watt-city/autonomous-car/(commit log)

2026-06-27 added sensor sheets
    [imu.kicad_sch, laserSensor.kicad_sch, ldo.kicad_sch, microcontroller.kicad_sch, power.kicad_sch, usb.kicad_sch, watt_city_car_pcb.kicad_sch]
2026-07-22 Initial commit
    Initial commit of the WATT City main board firmware for ESP32-S3, including setup for motors, sensors, and communication protocols.
2026-08-15 refactored repo so all car-related files are here added imu test code
    [imu.kicad_sch, laserSensor.kicad_sch, ldo.kicad_sch, microcontroller.kicad_sch, power.kicad_sch, usb.kicad_sch, watt_city_car_pcb.kicad_pcb, watt_city_car_pcb.kicad_sch]
2026-08-15 updated pcb
    [distSensor.kicad_sch, imu.kicad_sch, irArray.kicad_sch, laserSensor.kicad_sch, laserSensor0.kicad_sch, laserSensor1.kicad_sch, laserSensor2.kicad_sch, microcontroller.kicad_sch]
2026-08-15 renamed imu code, added calibrated laser dist sensor code
2026-08-15 qtr ir array working, calibrated to normalize readings from 0-1000
2026-08-15 added calibration code and hard-coded calibration constants into qtr_sensor_test
2026-08-18 integrated all sensors + ble
2026-08-18 initial pid line following code
2026-08-25 both motors working, encoders reading
2026-09-22 Tests motor controller & qtr sensor before PID
2026-09-22 Swap encoder pin definitions for ENC_R_A and ENC_R_B
2026-09-28 Enhance 'go' command with calibrated readings, base speed 2000 with lkp 0.5
2026-10-13 Remove KiCad backups and lock files, add .gitignore
    - Delete 70+ KiCad autosave zips, lock files, per-user .kicad_prl and
    an empty .history submodule entry from hardware/
    - Move the motor + encoder test from firmware/src/main/ into
    sensor_tests/motor_encoder_test/ so firmware/ only holds car sketches
    - Add .gitignore so these don't come back
    Claude-Session: https://claude.ai/code/session_01Wnp1WRYzGuosmDiJwmEC77
2026-10-13 Add README, CONTRIBUTING guide, and PR template
    README covers what the repo is, layout, setup, pin map, and known
    issues. CONTRIBUTING describes the branch + pull request workflow,
    KiCad and secrets rules. The PR template asks how changes were tested
    and what AI was used for.
    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
2026-11-04 main_board: read the camera's text TAG lines instead of the binary packet
    The team chose the text format that camera/firmware/xiao_apriltag_largest
    already sends. watt_link.h drops VisionPacket and the UART framing, keeps
    V2XPacket, and adds watt_parse_tag_line().
    - pollVision() assembles newline-terminated lines and parses them
    - Red-light stop uses the tag's apparent size (TAG_STOP_SIDE_PX, an
    estimate to replace with a measured value) since text has no range
    - Drops the camera "obstacle" flag; the ToF stop is unchanged
    Parser unit-tested on host against the camera's exact printf formats.
    Claude-Session: https://claude.ai/code/se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
